gciurpita/SpdTrp/(commit log)

2023-01-17 added flip so USB connect is at bottom
    [SpdTrp.ino, seg7disp.cpp, seg7disp.h]
2023-01-23 added testMode and switched to pinSt[]
